nilay994/swarm_lifi/documentation/README.md

## LiFi - documentation directory

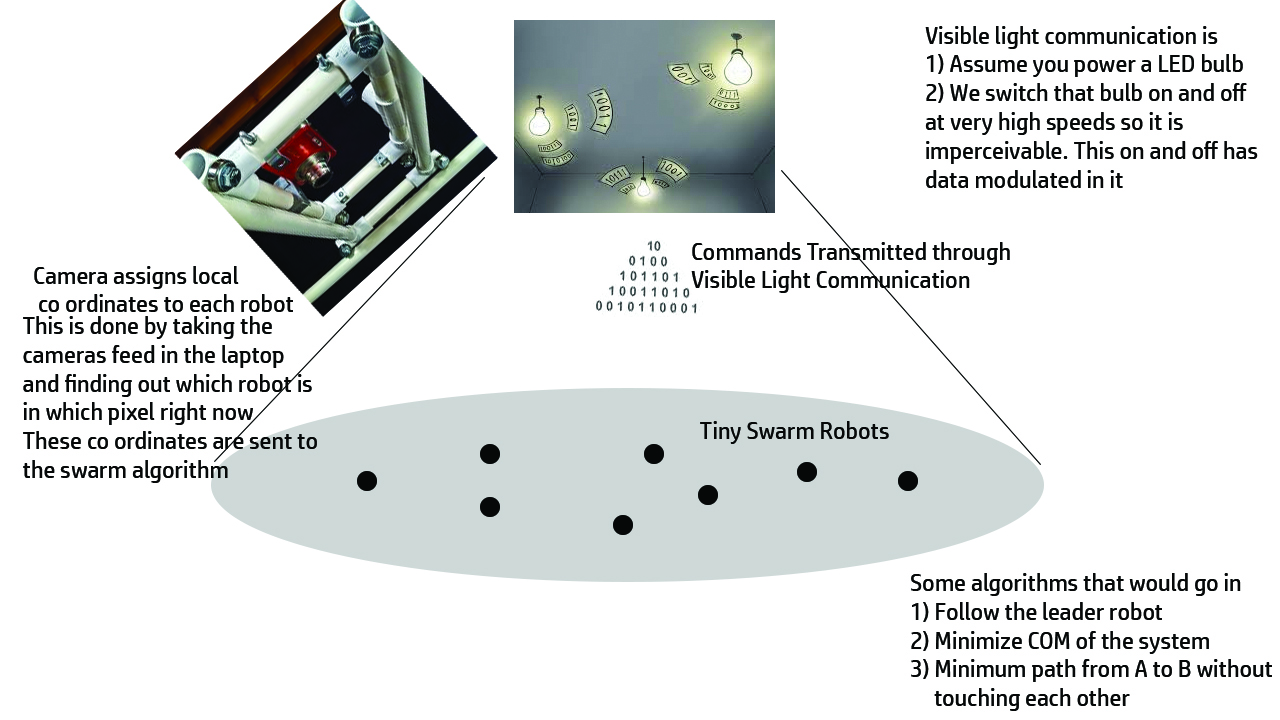
[picture p3: documentation/arena.jpg]
SWARM ARENA


1. swarm book is the submitted report in partial requirement of completion of our bachelors degree
2. papers from [disney research](https://www.disneyresearch.com/publication/led-to-led-visible-light-communication-networks/) have been cited heavily, thanks to their wonderful work on LiFi! 
3. swarmpres contains a short glimpse with some more illustrations~
4. refer to paper at [SIRS 2017](https://link.springer.com/chapter/10.1007/978-3-319-67934-1_18) Advances in Signal Processing and Intelligent Recognition Systems, for more details on the results of the LiFi swarm project
