nilay994/swarm_lifi/receiver/README.md

## Receiver

The receiver of the LiFi circuits was mounted on a couple of swarm robots, 
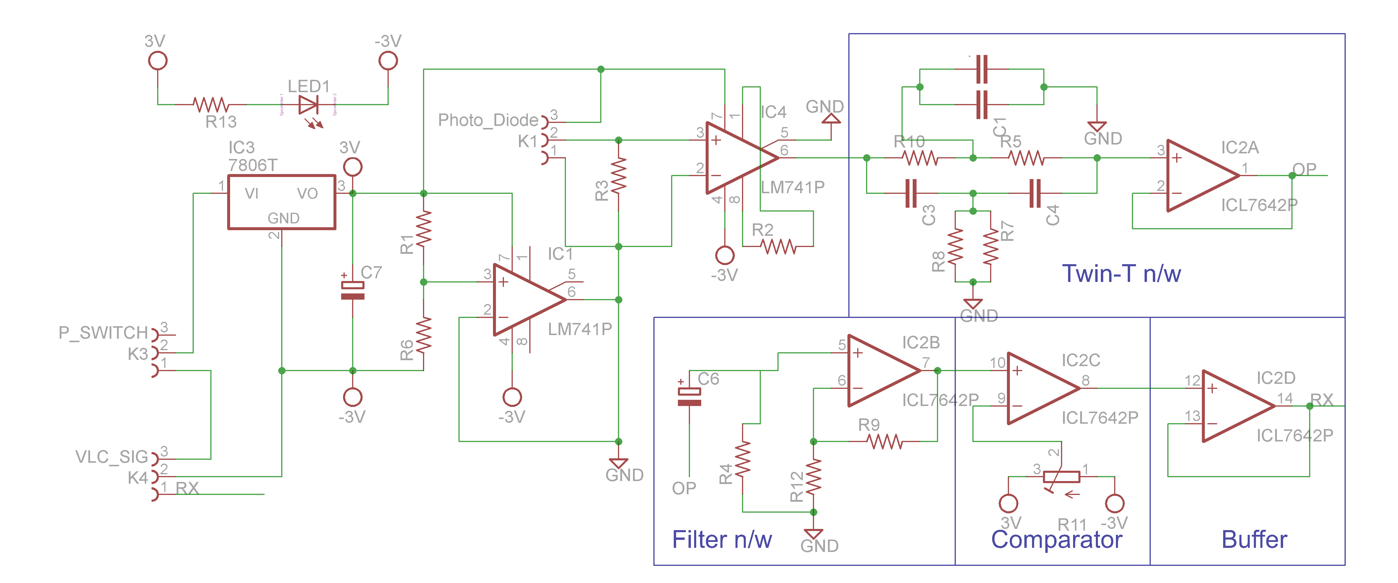
[picture p4: receiver/schema.png]
Schematics of the receiver
1. Schematics of the receiver 
2. [Closed loop P controller and Parser of the Swarm bot](https://github.com/nilay994/swarm_lifi/blob/master/receiver/swarm_rx.ino)
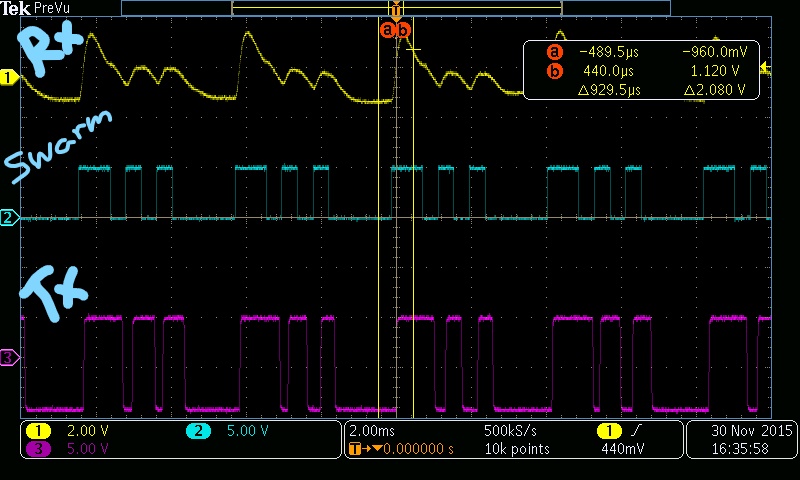
[picture p5: receiver/osc.jpg]
osc
3. Oscilloscope plots of LiFi Tx vs LiFi Rx before and after filtering.
