nilay994/swarm_lifi/documentation/swarmpres.pdf

# Swarm Robots In A Closed Loop Visual Odometry System By Using Li –Fi

VJTI Mumbai

# Motivation for Li-Fi

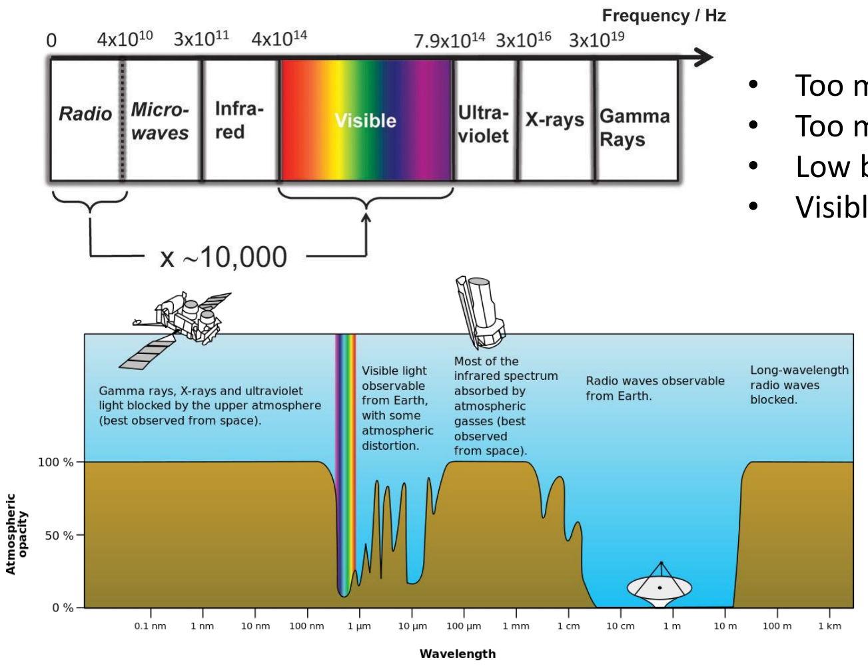
[picture p27: figure]

- Too many RF devices
- Too much interference in RF spectrum
- Low bandwidth in Radio N/W
- Visible is 10,000 times of RF

(WDM it out for occupying entire spectrum)

Li-Fi was believed to be complex, so we wanted to give it a try at DIY level and explore the scope of Simple unidirectional VLC networks

# Li-Fi goes everywhere

Hazardous environment
Communicating in areas where there is risk of explosions can be a problem (e.g. in mines, petro-chemical plants, oil rigs etc.) . VLC is inherently safe and provides both safe illumination and communications

Vehicle and Transportation
Many cars already LED lamps. Traffic signage, traffic lights, and street lamps are adopting the LED technology so there are massive applications opportunities here.

Defence and Security
The ability to send data quickly and in a secure way is the key to many applications. The fact that the visible light cannot be detected on the other side of a wall had great security advantages.VLC in Hospitals &amp; Healthcare

Hospitals and Healthcare
There are advantages for using VLC in hospitals and in healthcare. Mobile phones and WiFi’s are undesirable in certain parts of hospitals, especially around MRI scanners and in operating theatres.

WiFi Spectrum relief
WiFi’s have got faster over but cannot keep up with demand for wireless data. VLC can provide data rates greatly in excess of current WiFi and this can be done at low cost since the RF components and antenna system have been eliminated.

Aviation
Radio is undesirable in passenger compartments of aircraft. LEDs are already used for illumination and can also be used instead of wires to provide media services to passengers. This reduces the aircraft construction costs and its weight.

Underwater Communications
RF does not work underwater but visible light can support

# Motivation for Closed Loop Robots

- Odometry is the use of data from motion sensors to estimate change in position over time. Hence an important aspect in robotics.
- Needed closed loop, but traditionally,
(i) it involves wheel encoders- not accurate (ii) obstacle sensors – not enough
(iii) 2D laser scanners – too expensive
- Hence shifted to visual odometry- Efficient, cheap and requires one overhead camera and a PC
- The robots could be sent from A to B efficiently
- Robots could be assigned IDs and Pose estimation data could be directly acquired.

# Concurrent Research in this domain

LiFi
- Disney Research with ETH Zurich
– | Li-Fi OSI Model by Disney
– | Li-Fi Software for Sync
– | Bidirectional high rate LED communications
– | Feasibility for commercialization
- IEEE standards for Li-Fi are under process 802.15.7
- Commercialization and feasibility checks in various parts of the world – (Aeroplanes, traffic control, Indoor localizaton, etc)

Swarm robots and Odometry

- Robocup football robots
- Robocon Robots odometry
- SSL (Small sized league shared vision)

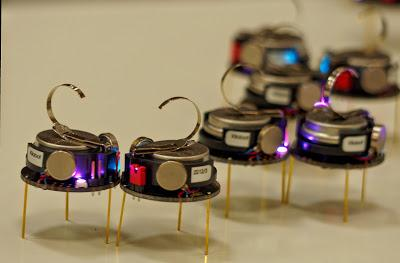
[picture p28: figure]
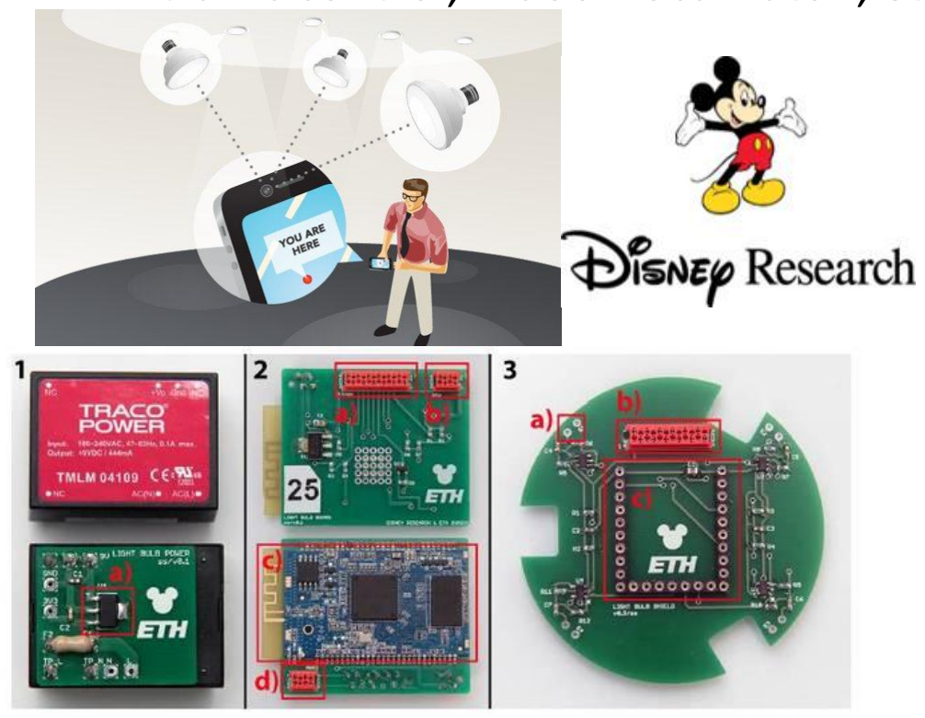
[picture p29: figure]
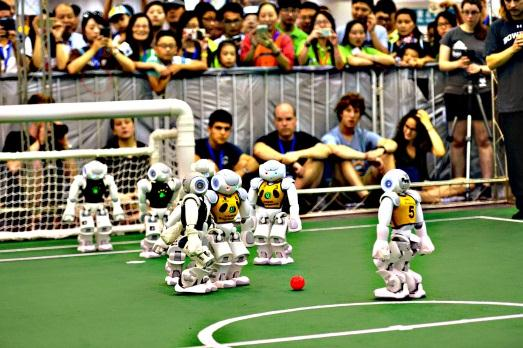
[picture p30: figure]

# Differences from other Li-Fi and Swarm Environments

Them | Us
All the protocols devised by Disney Research are on straight line of sight setups kept 2 cms away from each other | We have a solid angle of sensitivity of 60° at a maximum of 3 meters
All the faster protocols implement complex OFDM and WDM techniques to multiplex data to increase baud rates | we implemented simple baseband modulation at unperceivable baud rates using off the shelf components and robots are pinged sequentially via TDMA
Swarm environments generally permit robots to communicate with each other and also have provisions for establishing closed loop by themselves | The protocols and environment we developed are also valid for dumb swarm robots (ones who do not have any provision for sensing or communicating)
Visual odometry is perfomed with SLAM (Simulataneous Localization and Mapping Techniques) by onboard cameras | We have a stationary overhead camera which acts as a mock GPS for all the robots. On calibration we can extract YPR+XYZ (orientation+location) data

# Goal

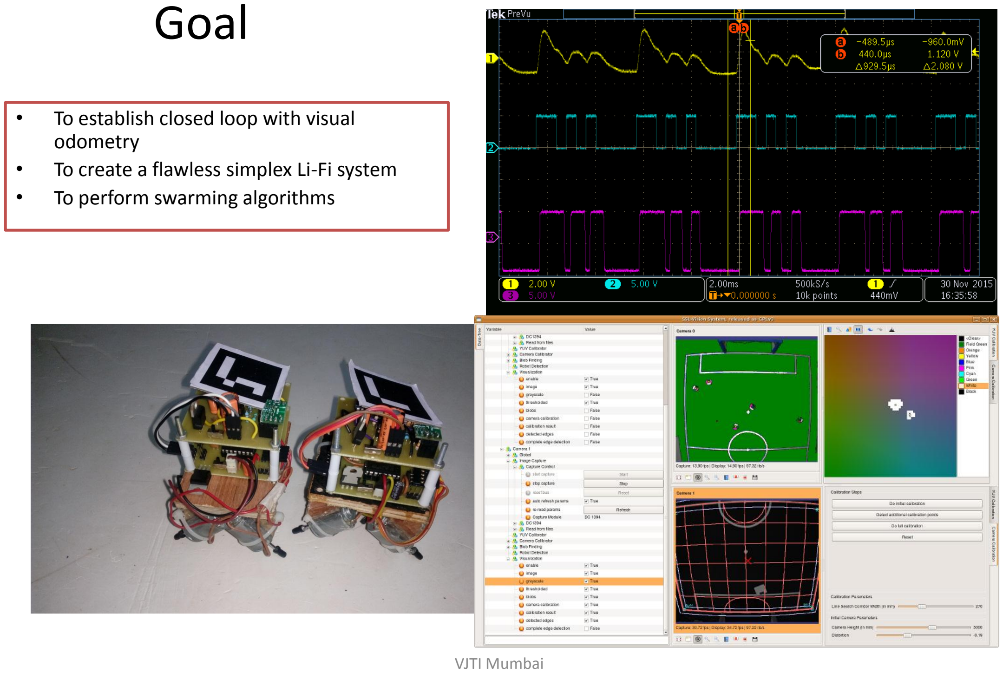
[picture p31: page 7]

- To establish closed loop with visual odometry
- To create a flawless simplex Li-Fi system
- To perform swarming algorithms

# Merged Li-Fi with Swarm to make closed loop swarm robots with Visual odometry

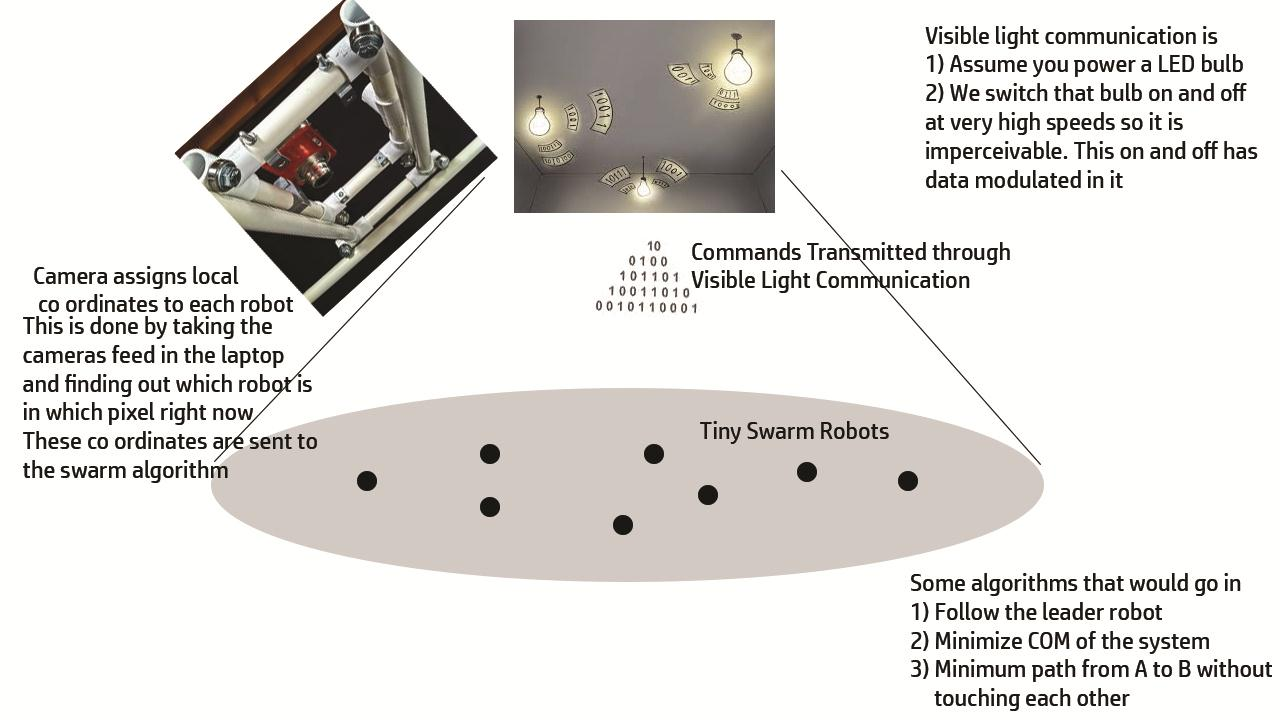
[picture p32: page 8]

# LiFi Transmitter

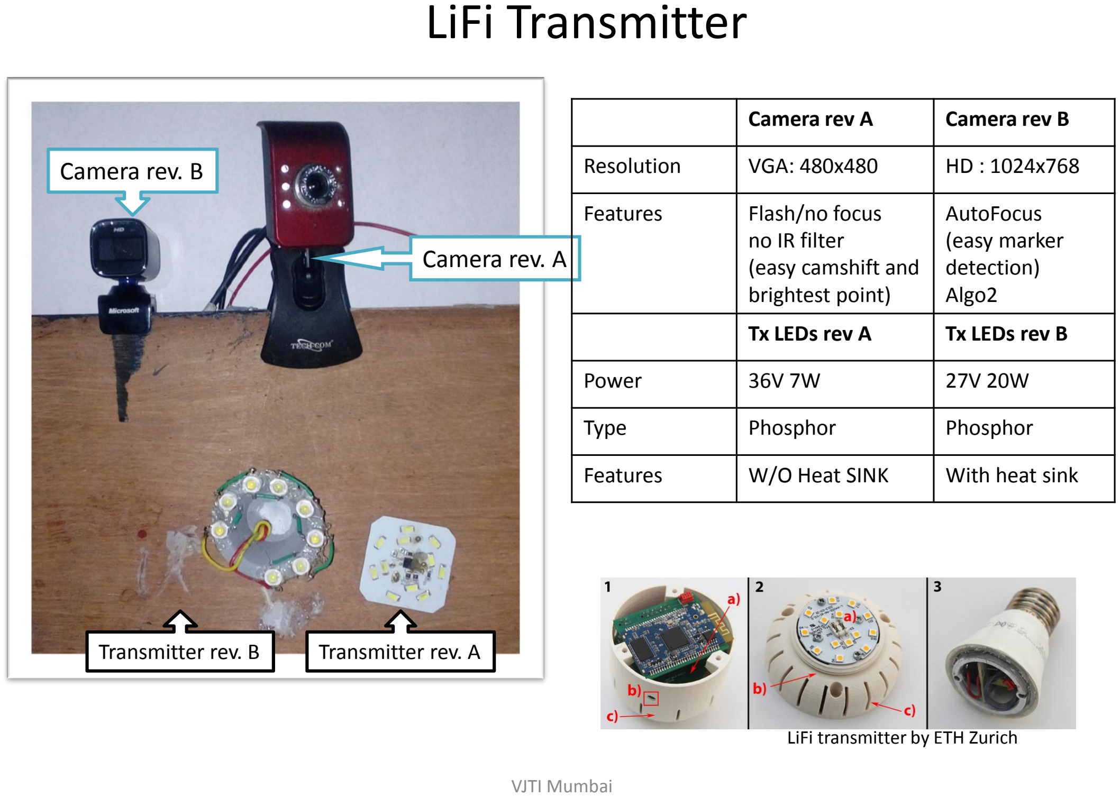
[picture p33: page 9]

Transmitter rev. B Transmitter rev. A

Camera rev. A

Camera rev. B

| Camera rev A | Camera rev B
Resolution | VGA: 480x480 | HD : 1024x768
Features | Flash/no focus no IR filter (easy camshift and brightest point) | AutoFocus (easy marker detection) Algo2
| Tx LEDs rev A | Tx LEDs rev B
Power | 36V 7W | 27V 20W
Type | Phosphor | Phosphor
Features | W/O Heat SINK | With heat sink

LiFi transmitter by ETH Zurich

# Choosing the LiFi Rx Tx

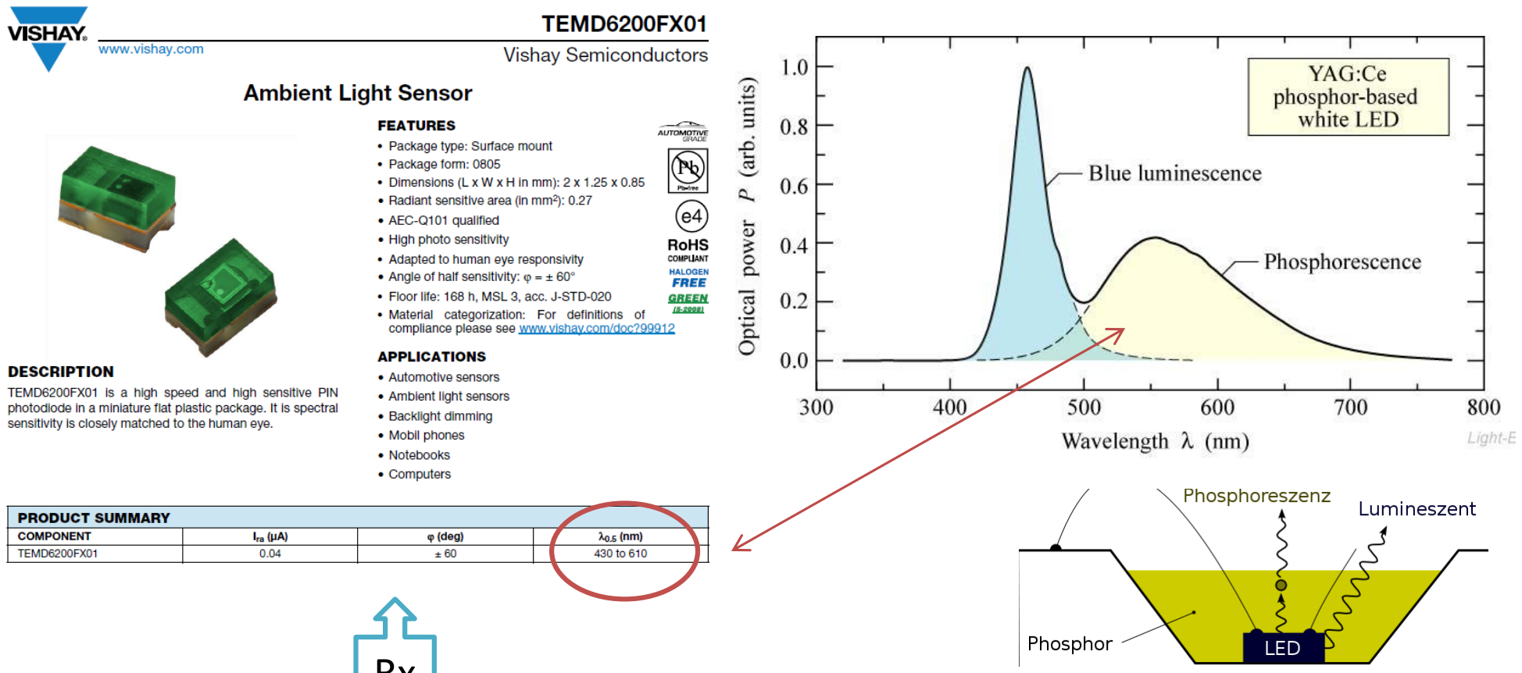
[picture p34: figure]

Tx

Rx

# Setting up the Transmitter

- A COM port device to switch USB data to Serial UART data
- Echo-device to keep repeating last sent packet to keep the channel occupied always- or else external noise give garbage values @Rx end
- Arduino was chosen as the UART and repeater device and MOS IRF3710 was chosen as the switching device
- The receiver had a peak sensitivity around phosphor LED’s max power sub wavelength. Hence phosphor LED was chosen. The system was tested to work flawlessly at 3m even in the presence of external sunlight and other ambient lighting devices.
- The wattage was increased to increase the distance and parallel capacitor which prevented dimming was removed.
- Heat sinks were introduced to dissipate heat out of the LEDs to prevent burn-off

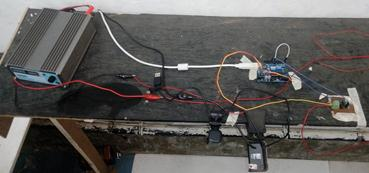
[picture p35: figure]
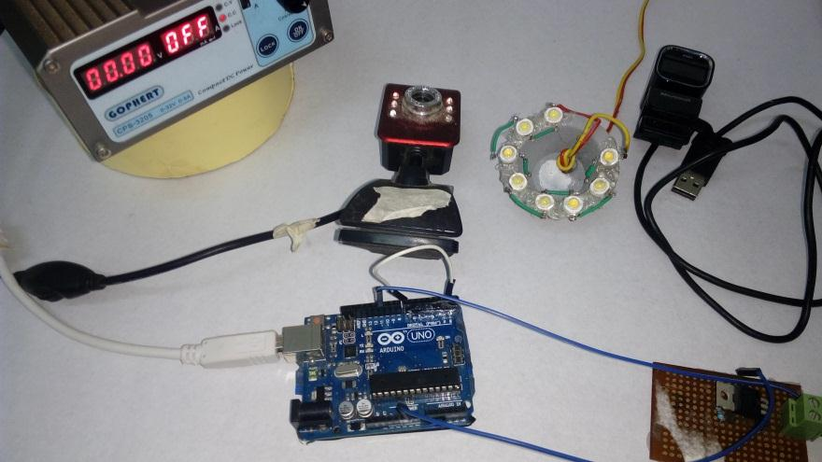
[picture p36: figure]

# Setting up the Receiver

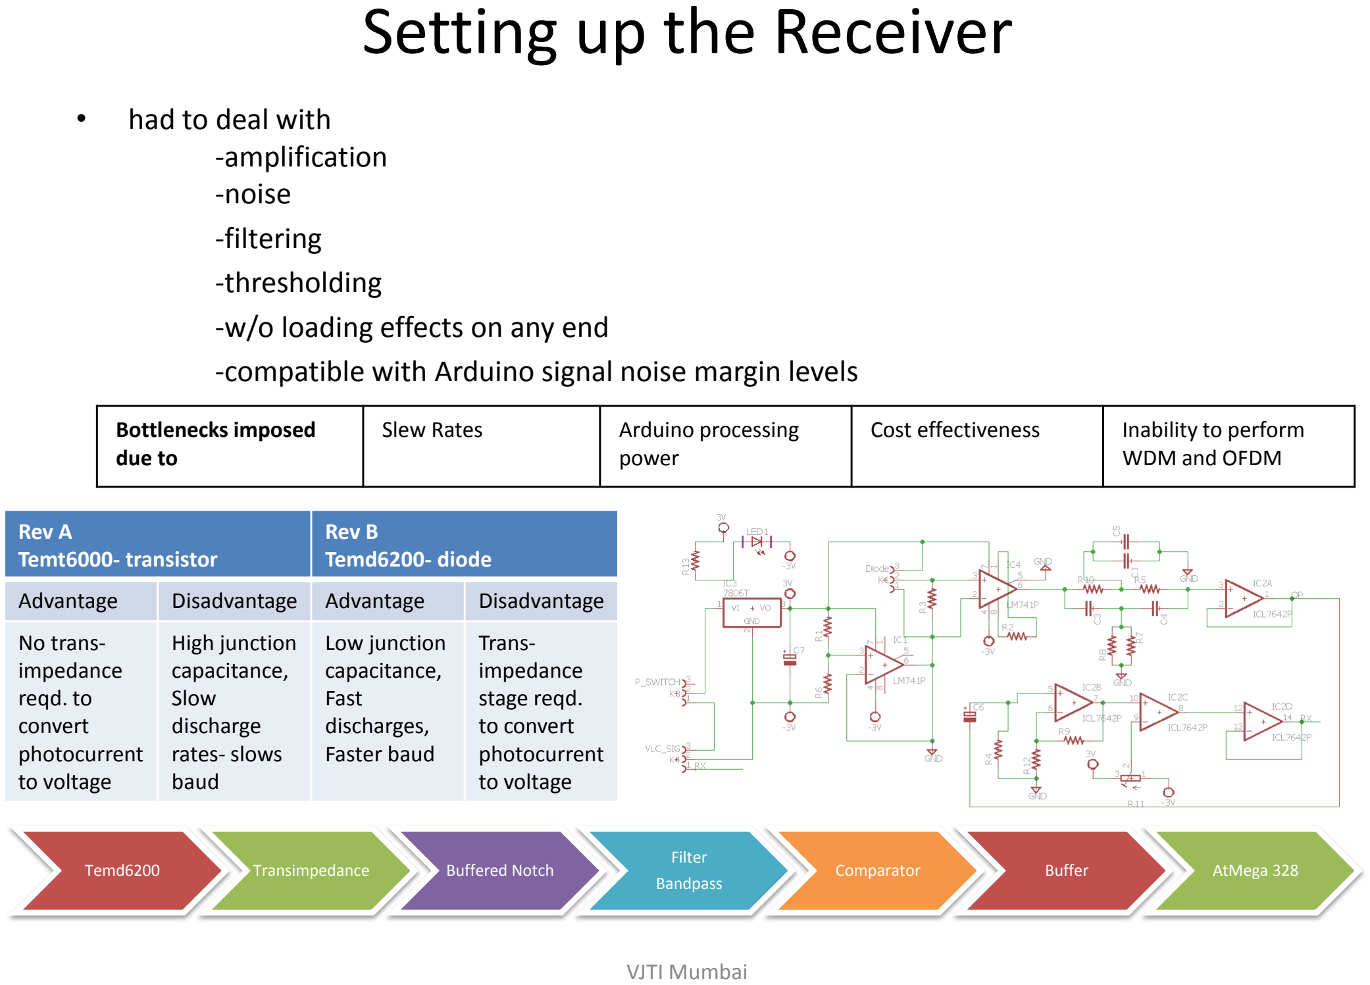
[picture p37: page 12]

- had to deal with
-amplification
-noise
-filtering
-thresholding
-w/o loading effects on any end
-compatible with Arduino signal noise margin levels
Temd6200 | Transimpedance | Buffered Notch

Filter
Bandpass
Comparator | Buffer | AtMega 328

Bottlenecks imposed
due to
Slew Rates | Arduino processing
power
Cost effectiveness | Inability to perform
WDM and OFDM
Rev A Temt6000- transistor | Rev B Temd6200- diode
Advantage | Disadvantage | Advantage | Disadvantage
No trans-impedance reqd. to convert photocurrent to voltage | High junction capacitance, Slow discharge rates- slows baud | Low junction capacitance, Fast discharges, Faster baud | Trans-impedance stage reqd. to convert photocurrent to voltage

# Setting up the bot

- The swarm bots had to be small in size
- Circuit CAD and Design CAD were fabricated
- Off board programming and charging
- Shifting boot-loaders to new AtMegas and interfacing motor drivers
- Motors were off the shelf 12v DC motors (mfg. by Mabuchi) without a gearbox since minimal torque could drag the robot. Wheel not coupled as it increased the radius and hence the torque reqd.
- Batteries were BL-5C Lithium Ions – standard 3.7V cellphone batteries. They were coupled in series to give out 7.4V at a capacity of 800mAh. Each robot can run for 2 hours on a single charge.

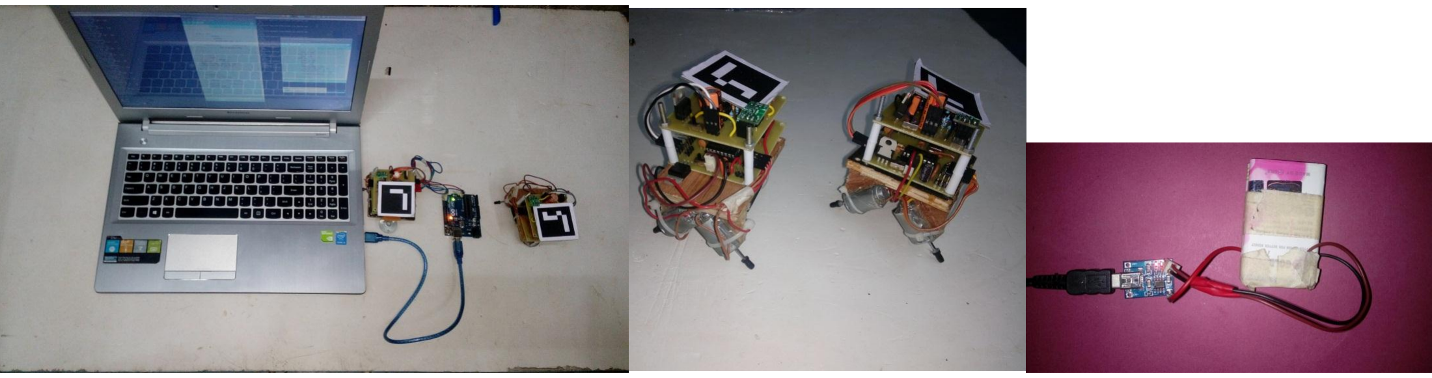
[picture p38: figure]

Programming the robot | Bots in action | Charging the Li-Ion

# Working on Image processing Algorithms

Algorithms | Rev A | Rev B | Rev C
Detection | HSV thresholding | Camshift | ARuco
Orientation info | NA | IR LED, Angle of CM and brightest point to give angle of robot | Pose estimation Edges of marker gives out angle of robot
Threading | CPU | Threaded to GPU | CPU
FPS | 15 | 20 | 22
Error to destination | Thetapreviouswithgoal -thetacurrentwithgoal | Thetabot- thetagoal | Thetabot- thetagoal
Efficiency | Least | Better | Best
Robot IDs | NA | IR LED of the destination robot is turned on | ARuco hamming codes
Multi-robot control | Not possible | Complex | Simple but requires Camera calib
Flowchart | 1. Threshold via HSV 2. Convert to binary workspace 3. Erode & Dilate 4. cv::findContours 5. Moments[10] = centre of mass 6. Plot lines and select goal points | 1. Backprojection with histogram normailization 2. meanShift to cluster contour 3. Track contour | 1. Adaptive Thresholding 2. Findcontours 3. Polygonal approximation of 4 corners 4. Refine corners using subpixel interpolation 5. Frontal perspective of marker by homography 6. Otsu thresholding and hamming decode

Errors were sent in to GotoGoal P controllers which minimize the orientation error of each robot

# Path trajectories before arriving to arUco

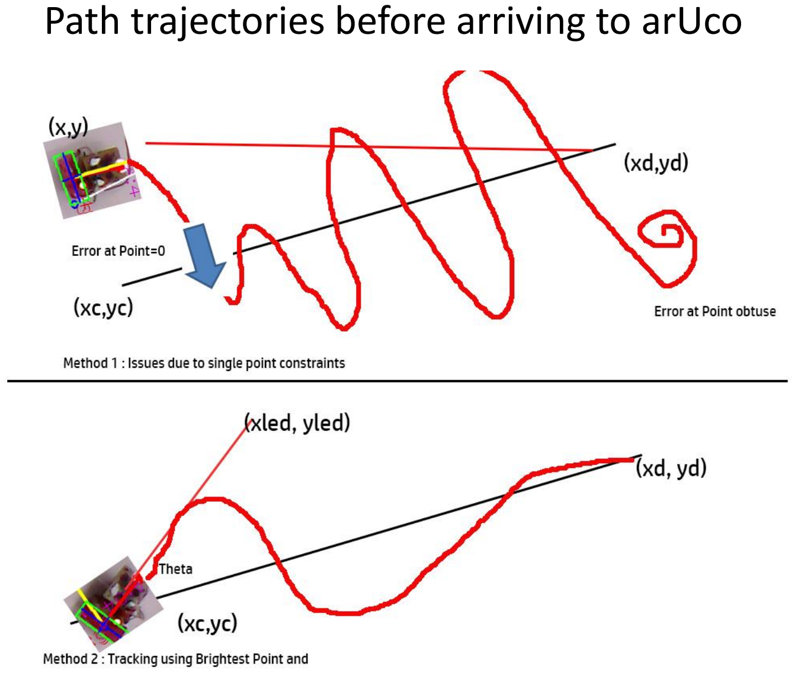
[picture p39: page 15]

# Includes and libraries used for final algorithm

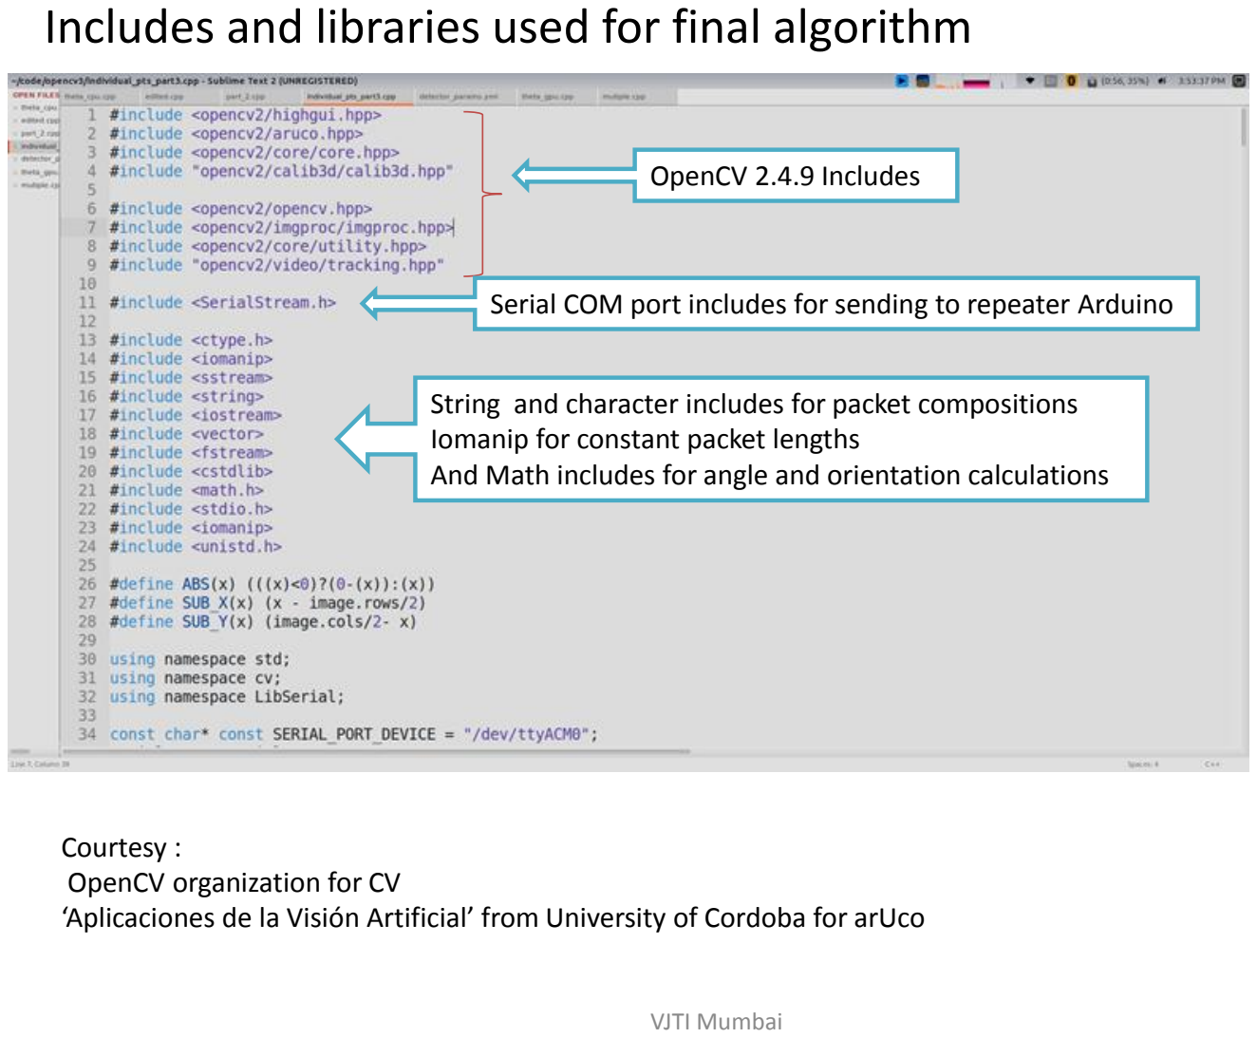
[picture p40: page 16]

OpenCV 2.4.9 Includes

Serial COM port includes for sending to repeater Arduino

String and character includes for packet compositions Iomanip for constant packet lengths
And Math includes for angle and orientation calculations

Courtesy :
OpenCV organization for CV
‘Aplicaciones de la Visión Artificial’ from University of Cordoba for arUco

# Path planning Algorithms

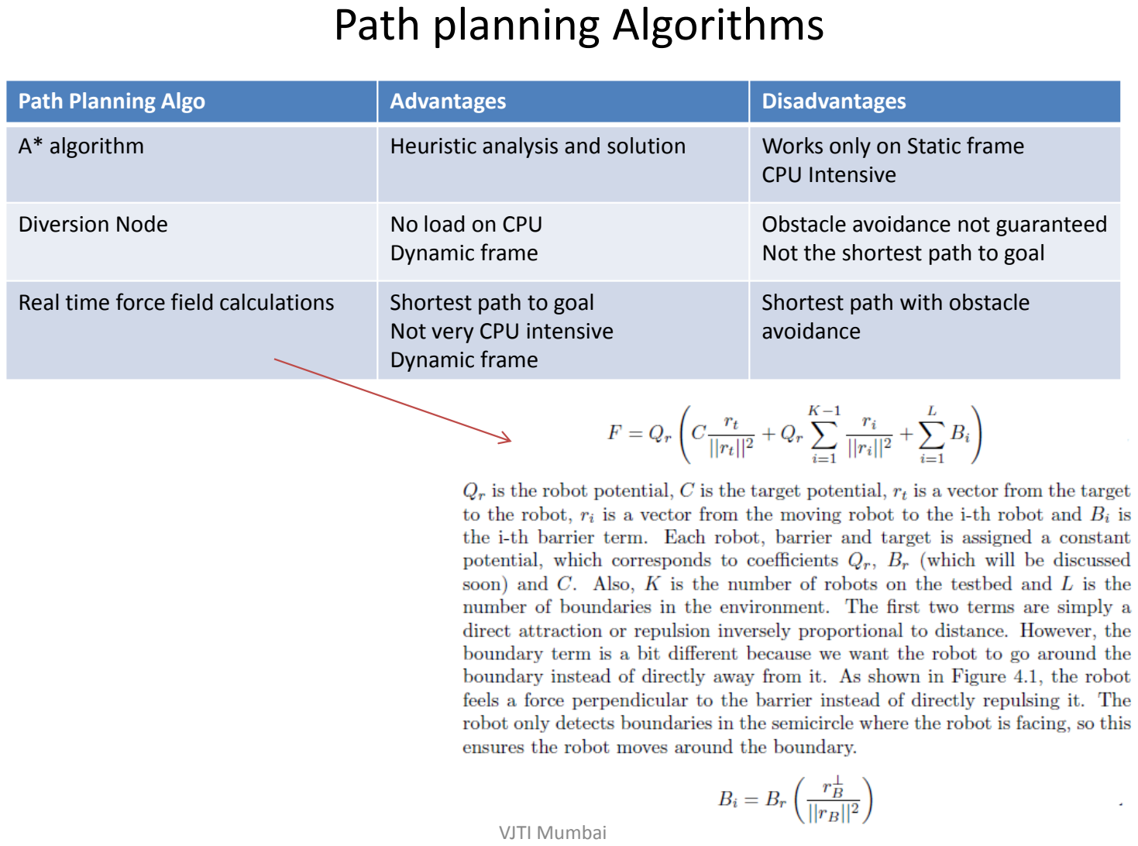
[picture p41: page 17]

Path Planning Algo | Advantages | Disadvantages
A* algorithm | Heuristic analysis and solution | Works only on Static frame CPU Intensive
Diversion Node | No load on CPU Dynamic frame | Obstacle avoidance not guaranteed Not the shortest path to goal
Real time force field calculations | Shortest path to goal Not very CPU intensive Dynamic frame | Shortest path with obstacle avoidance

# Serial Packets and Parsing

Type | Header | Instruction | Robot ID | Error | Trailer
Length | 5 bytes | 2 bytes | 3 bytes | 3 bytes | 4 bytes
Description | “start” Start of frame | “30” : go “25” : stop | arUco robot ID | Heading error Offset by 180 | “stop” End of frame
Example of typical frame | Start | 30 | 768 | 200 | stop

The frame composed : “start30768200stop” Indicates
Robot no 768 should go in
Dynamic mode
With an error of 200-180=20

Pwmright= fwd+20
Pwmleft=fwd-20
If fwd=80

Motorright will go forward with a speed of 100 MotorLeft will go forward with a speed of 60 And robot will differentially take a left.

The frame is broadcasted to all robots, But the relevant ID robot picks up its error, while other robots continue execution of last error.

### Error Refresh Rate per robot

- The error carried in the frame is 3/(5+2+3+3+4)th part of the frame.
- The baud rate currently is 19.2kbps
- The frames are sent out sequentially to N robots.
- Error refresh rate will hence be
(19200 x 3 )
(N x 17)

# Shifting to more ambitious steps

### - Increasing the distance of communication and area of workspace - Designing filters, diffusers and windows for transmitting and receiving LEDs - Testing Swarm algorithms like Consensus, follow the leader and pattern formations - Onboard programmers and charging on swarm bots

Inspiration | References-Swarm | References- LiFi
- Lifi-gets-ready-to-compete-with-wifi – IEEE spectrum
article
- 802.15.7 protocol article by IEEE on the infrastructure level implementation of LiFi
- TED Talk by Harald Haas on Li-Fi on every bulb
- Michael Rubenstein on "Kilobot: A low cost scalable robot system for collective behaviors" at "Robotics and Automation
(ICRA), 2012 IEEE International Conference"
- Bin Feng, Yuan Gao on
“Development of Strategy
Software Algorithm Simulators for Multi-Agent System in
Dynamic Environments
Technology and
Communication” -2013 from
Vaasan Ammattikorkeakoulu
VAMK, University of Applied Sciences
- Paril Jain, “Odometry and motion planning for omni drive robots” Computational
Intelligence on Power, Energy and Controls with their impact on Humanity (CIPECH), Nov
2014
- Datasheet, Atmel co-operation Atmega 328 datasheet for PWM and USART
- Harald Haas on "Principles of LED Light Communications Towards Networked Li-Fi" published with “Cambridge University Press” in 2015 being editor of IEEE Transactions on Communications and IEEE Journal of Lightwave Technologies
- Stefan Mangold, “Linux Light Bulbs: Enabling Internet Protocol Connectivity for Light Bulb Networks” at “Workshop on Visible Light Communication Systems (VLCS)” on September 7, 2015
- Stefan Mangold, “Using Consumer LED Light Bulbs for Low-Cost Visible Light Communication Systems” at “Workshop on Visible Light Communication Systems (VLCS)” on September 7, 2014
- Stefan Mangold, “ LED-to-LED Visible Light Communication Networks” at “ACM International Symposium on Mobile Ad Hoc Networking and Computing (ACM MobiHoc)” on August 1, 2013
- Luis Orozco on “Optimizing Precision Photodiode Sensor Circuit Design” published in “Application notes of Analog Devices, Inc” for Transimpedance stage in Receivers
- Bruce Carter on “Filter Design in Thirty Seconds” published in “High Performance Analog Texas Instruments”
- Datasheet: TEMD6200FX01 by Vishay Semiconductors
- Ambient Light Sensors - Circuit and Window Design Vishay – filtering amplifying and window size
- http://www.lifi.eng.ed.ac.uk/li-fi-research-publications
